wagiminator/CH32X033-USB-Knob/hardware/USB_Knob_BOM.tsv

ID | Name | Designator | Footprint | Quantity | Manufacturer Part | Manufacturer | Supplier | Supplier Part
1 | 100n | C1,C3,C4,C5 | C_0603 | 4 | CC0603KRX7R9BB104 | YAGEO | LCSC | C14663
2 | 10u | C2 | C_0603 | 1 | CL10A106KP8NNNC | SAMSUNG | LCSC | C19702
3 | WS2812-2020 | LED1,LED2,LED3,LED4,LED5,LED6,LED7,LED8,LED9,LED10,LED11 | WS2812-2020 | 11 | WS2812C-2020 | worldsemi | LCSC | C965556
4 | 1k | R1 | 0603 | 1 | 0603WAF1001T5E | UniOhm | LCSC | C21190
5 | 5k1 | R2,R3 | 0603 | 2 | 0603WAF5101T5E | UNI-ROYAL(厚声) | LCSC | C23186
6 | 330R | R4 | 0603 | 1 | 0603WAF3300T5E | UniOhm | LCSC | C23138
7 | BOOT | SW1 | SW-SMD_L4.0-W2.9-LS5.0 | 1 | YTS1T0092CBG00 | YIYUAN(怡远) | LCSC | C5221275
8 | Rotary Encoder | SW2 | ROTARY_ENCODER | 1 | PEC11R-4015F-S0024 | BOURNS | LCSC | C143789
9 | CH32X033F8P6 | U1 | TSSOP-20 | 1 | CH32X033F8P6 | WCH(南京沁恒) | LCSC
10 | GT-USB-7010ASV | U2 | USB-C-7010ASV-SX | 1 | GT-USB-7010ASV | G-Switch(品赞) | LCSC | C2988369
