wagiminator/CH32X033-USB-Knob/3dprint/USB_Knob_case_ring.stl

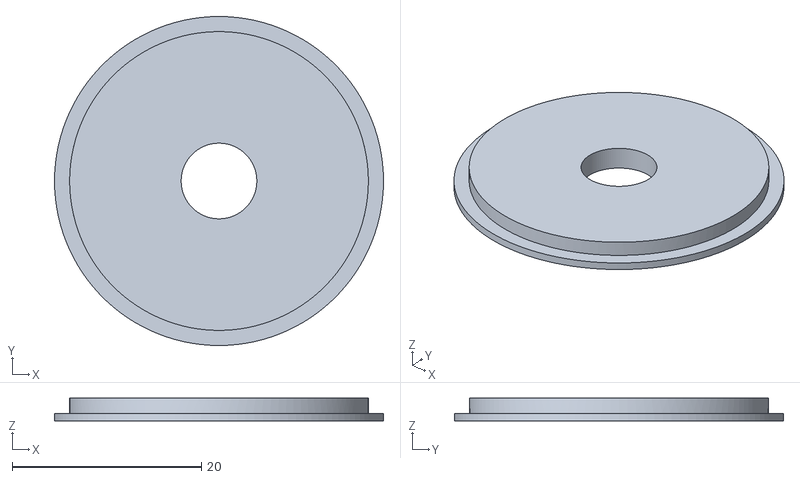
[picture p5: CAD file, 2024-03-10]
3dprint/USB_Knob_case_ring.stl
34.8 x 34.8 x 2.40
