wagiminator/CH32X033-USB-Knob/3dprint/USB_Knob_case_top.stl

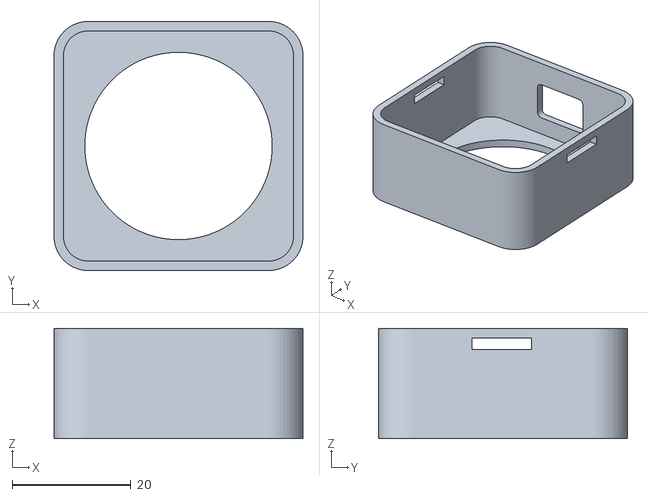
[picture p6: CAD file, 2024-03-10]
3dprint/USB_Knob_case_top.stl
42.0 x 42.0 x 18.6
