wagiminator/CH32X033-USB-Knob/3dprint/USB_Knob_knob.stl

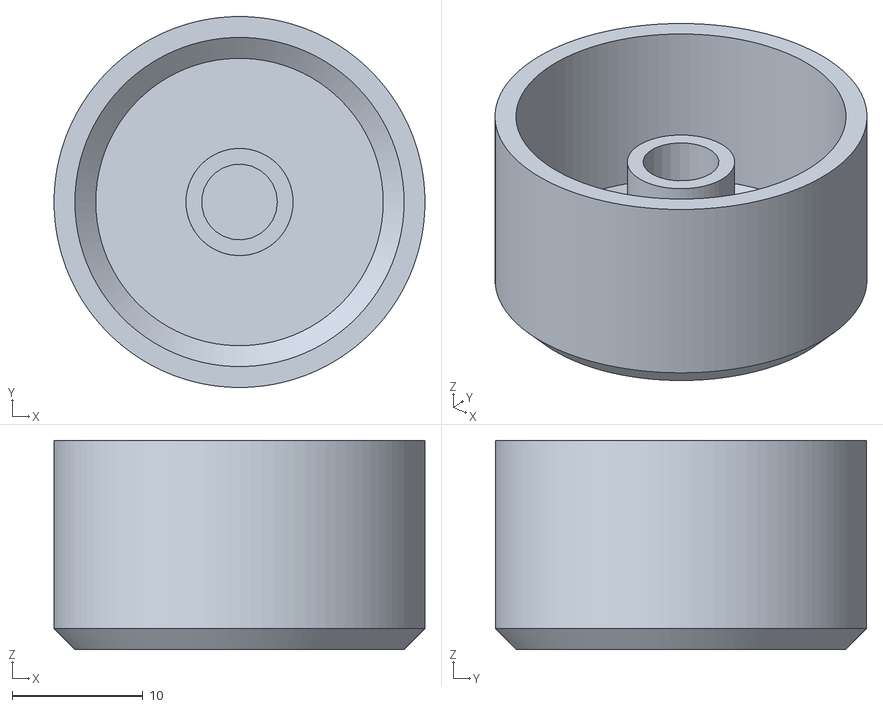
[picture p7: CAD file, 2024-03-10]
3dprint/USB_Knob_knob.stl
28.4 x 28.4 x 16.0
