wagiminator/CH32X033-USB-Knob/3dprint/USB_Knob_case.fcstd

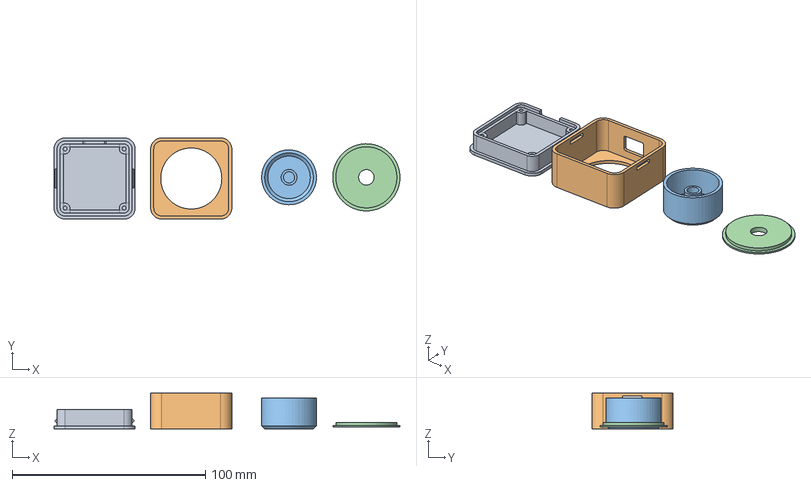
[picture p8: CAD file, 2024-03-10]
3dprint/USB_Knob_case.fcstd
179.0 x 42.0 x 18.6 mm
Boden
Deckel
Knob
LED-Ring
