wagiminator/CH32X033-USB-Knob/3dprint/USB_Knob_case_bottom.stl

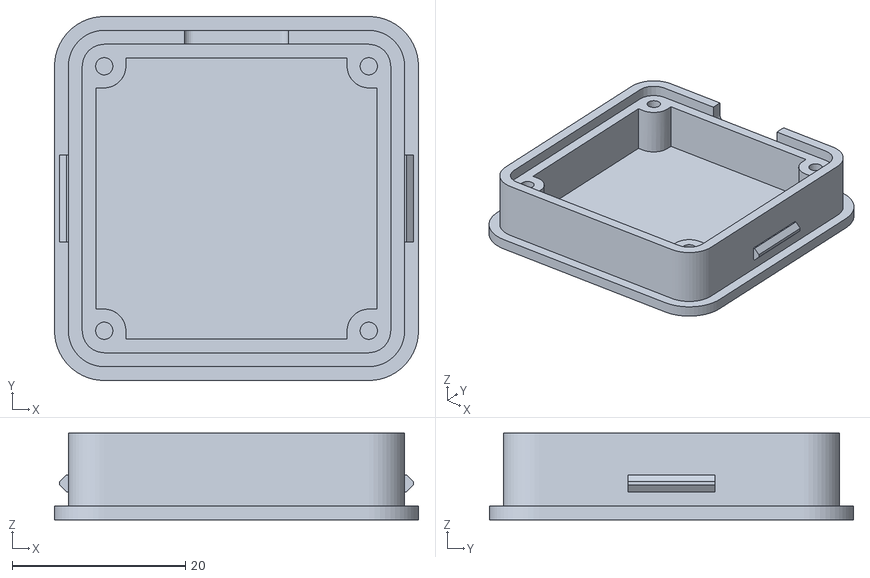
[picture p9: CAD file, 2024-03-10]
3dprint/USB_Knob_case_bottom.stl
42.0 x 42.0 x 10.0
