wagiminator/CH32X033-USB-Knob/hardware/USB_Knob_schematic.pdf

## Microcontroller

## Capacitors

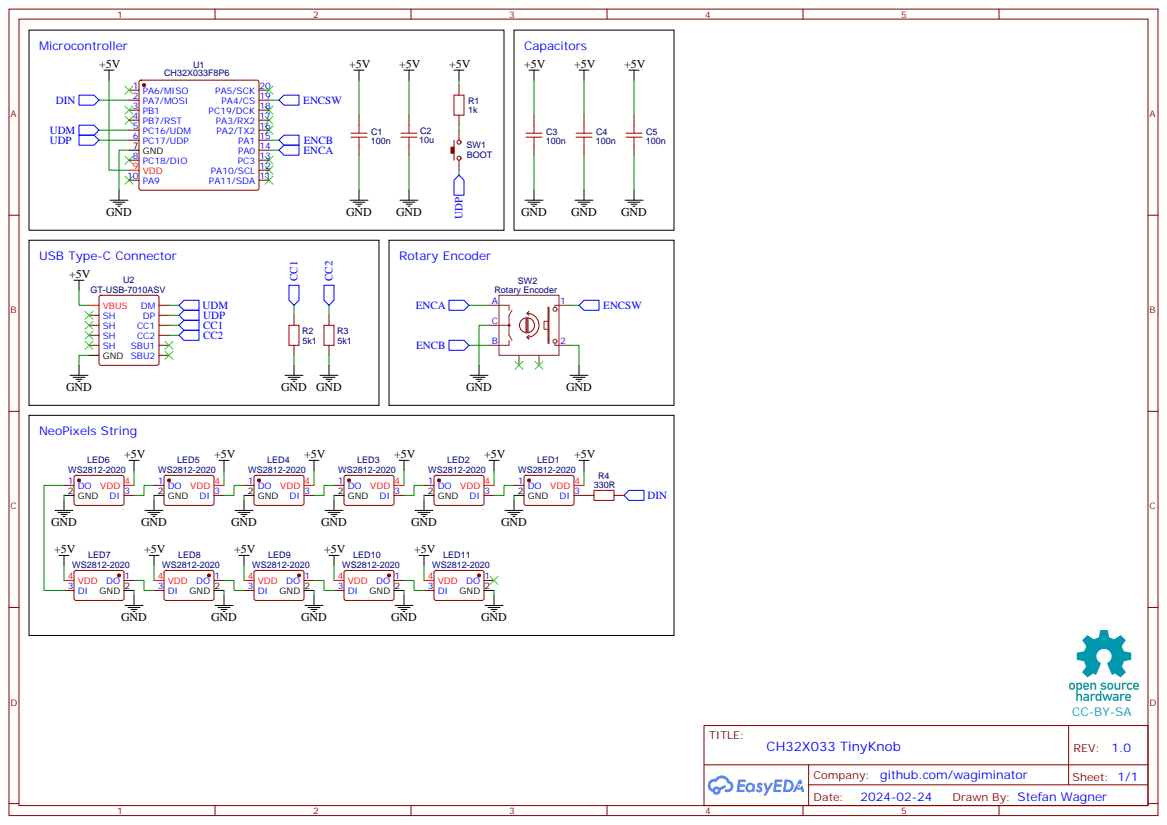
[picture p10: page 1]

Company: github.com/wagiminator

Drawn By: Stefan Wagner
